wjdaudgns120-max/STM32_CardAccess_HotelElevator_Project/docs/images/overview.png

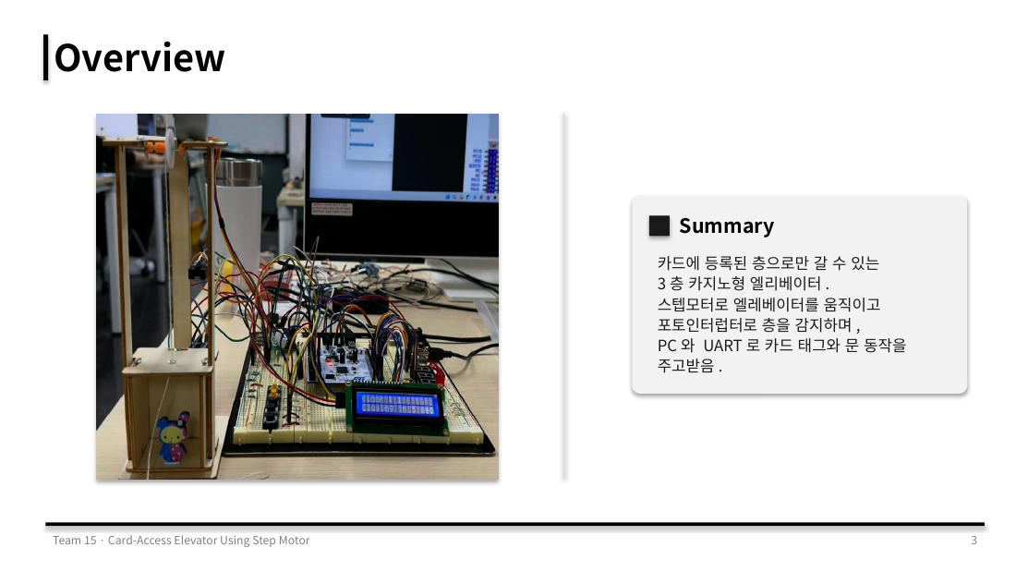
docs/images/overview.png
