wjdaudgns120-max/STM32_CardAccess_HotelElevator_Project/docs/images/pin_map.png

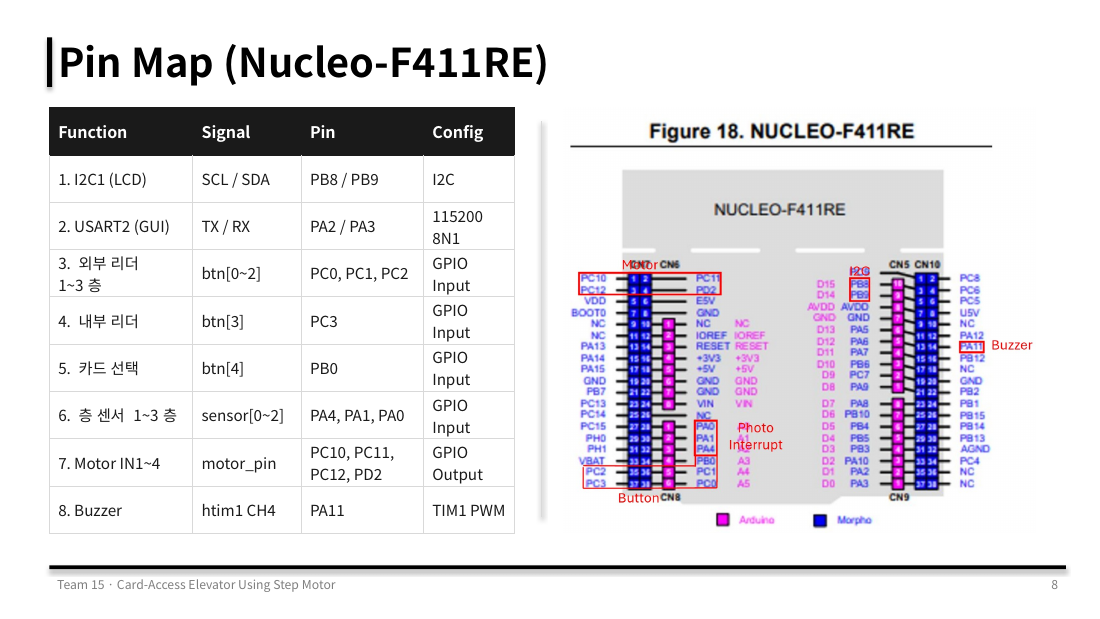
docs/images/pin_map.png
