wjdaudgns120-max/STM32_CardAccess_HotelElevator_Project/test_elevator.ioc

Mcu.UserName=STM32F411RETx
PA0-WKUP.Signal=GPIO_Input
PA1.Signal=GPIO_Input
PA10.Signal=GPIO_Output
PA11.Signal=S_TIM1_CH4
PA13.Signal=SYS_JTMS-SWDIO
PA14.Signal=SYS_JTCK-SWCLK
PA2.Signal=USART2_TX
PA3.Signal=USART2_RX
PA4.Signal=GPIO_Input
PA5.Signal=GPIO_Output
PA6.Signal=GPIO_Output
PA7.Signal=GPIO_Output
PA8.Signal=GPIO_Output
PA9.Signal=GPIO_Output
PB0.Signal=GPIO_Input
PB10.Signal=GPIO_Output
PB3.Signal=GPIO_Output
PB4.Signal=GPIO_Output
PB5.Signal=GPIO_Output
PB6.Signal=GPIO_Output
PB8.Signal=I2C1_SCL
PB9.Signal=I2C1_SDA
PC0.Signal=GPIO_Input
PC1.Signal=GPIO_Input
PC10.Signal=GPIO_Output
PC11.Signal=GPIO_Output
PC12.Signal=GPIO_Output
PC13-ANTI_TAMP.Signal=GPIO_Input
PC14-OSC32_IN.Signal=GPIO_Input
PC15-OSC32_OUT.Signal=GPIO_Input
PC2.Signal=GPIO_Input
PC3.Signal=GPIO_Input
PC7.Signal=GPIO_Output
PD2.Signal=GPIO_Output
